KN-NaMi/spin-coater/mechanics/motor_assembly/Motor_assembly.FCStd

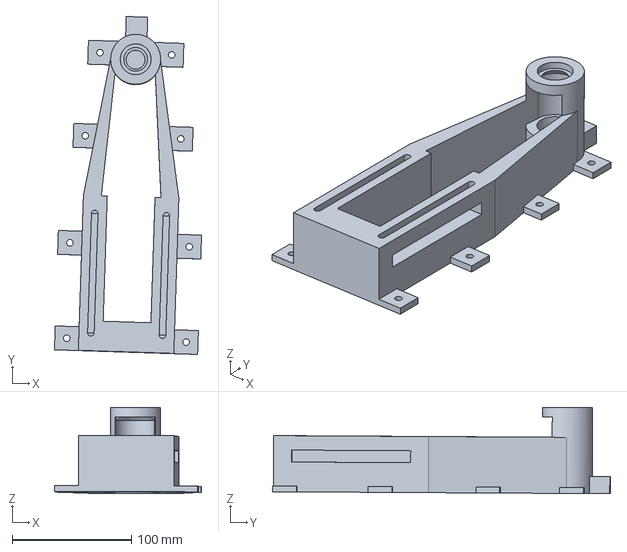
[picture p1: CAD file, 2026-07-07]
mechanics/motor_assembly/Motor_assembly.FCStd
123.2 x 283.1 x 72.3 mm
