KN-NaMi/spin-coater/mechanics/print_files/motor_assembly_tpu.step

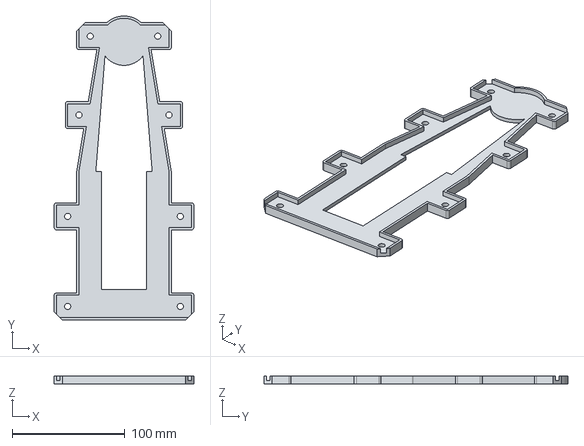
[picture p2: CAD file, 2026-07-07]
mechanics/print_files/motor_assembly_tpu.step
124.0 x 269.9 x 7.00 mm
