KN-NaMi/spin-coater/mechanics/print_files/splatter_guard_main_body.step

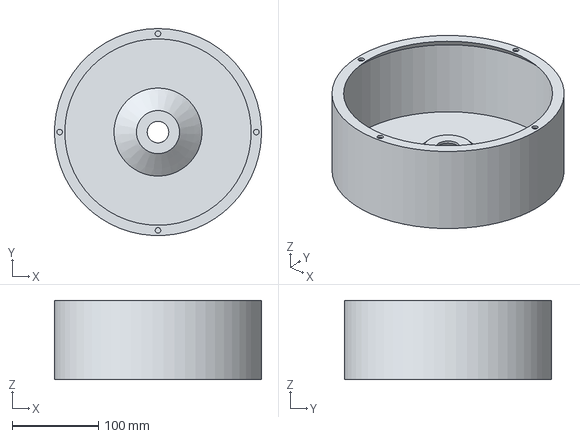
[picture p3: CAD file, 2026-07-07]
mechanics/print_files/splatter_guard_main_body.step
239.9 x 239.8 x 92.0 mm
