KN-NaMi/spin-coater/mechanics/enclosure/enclosure.FCStd

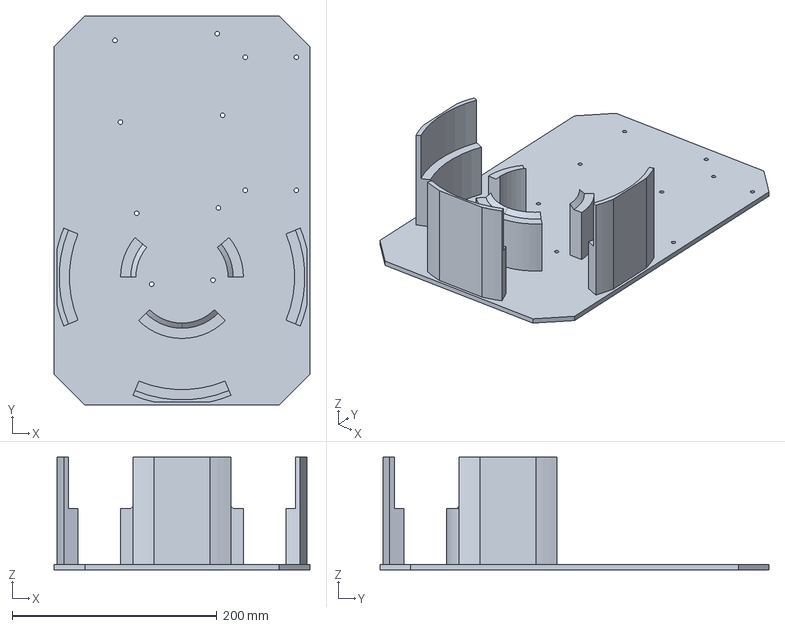
[picture p4: CAD file, 2026-07-07]
mechanics/enclosure/enclosure.FCStd
250.0 x 380.0 x 110.0 mm
