KN-NaMi/spin-coater/mechanics/pulley_parametric/GT2_Pulley_Parametric.FCStd

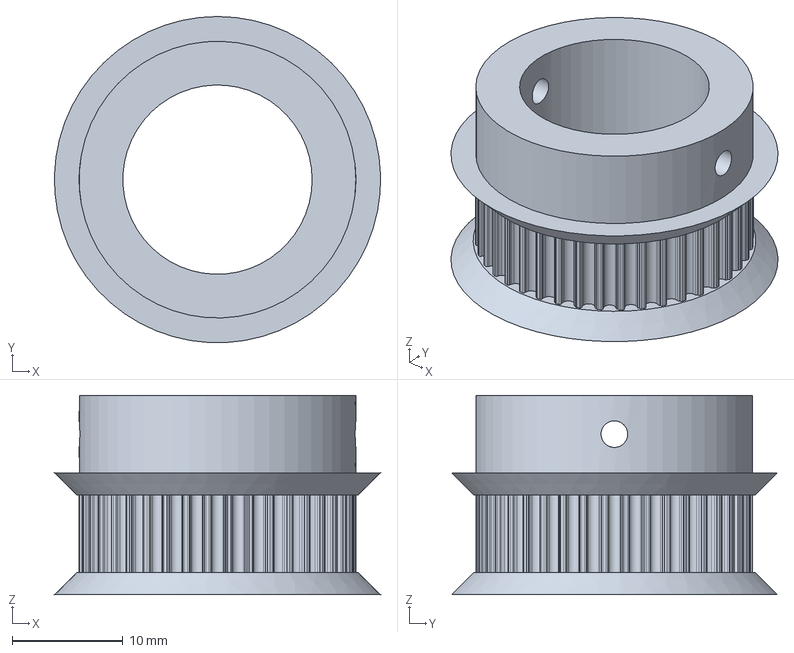
[picture p5: CAD file, 2026-03-24]
mechanics/pulley_parametric/GT2_Pulley_Parametric.FCStd
29.5 x 29.5 x 18.0 mm
