KN-NaMi/spin-coater/mechanics/splatter_guard/Splatter guard.FCStd

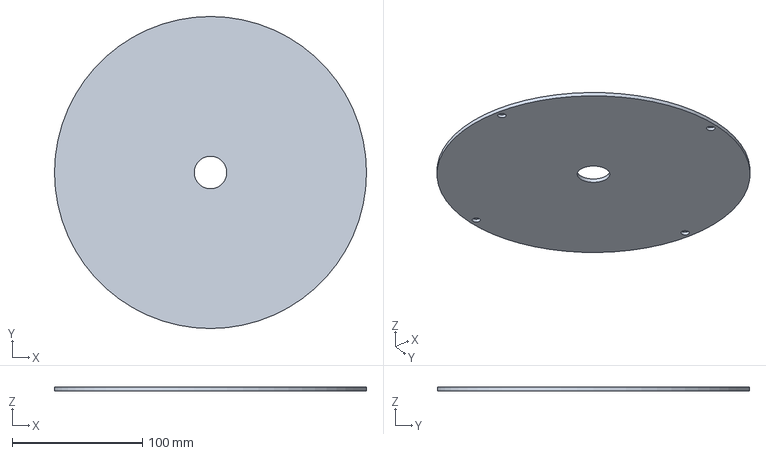
[picture p6: CAD file, 2026-07-07]
mechanics/splatter_guard/Splatter guard.FCStd
240.0 x 240.0 x 3.00 mm
