KN-NaMi/spin-coater/mechanics/Vaccum Pump/Vaccum Pump.FCStd

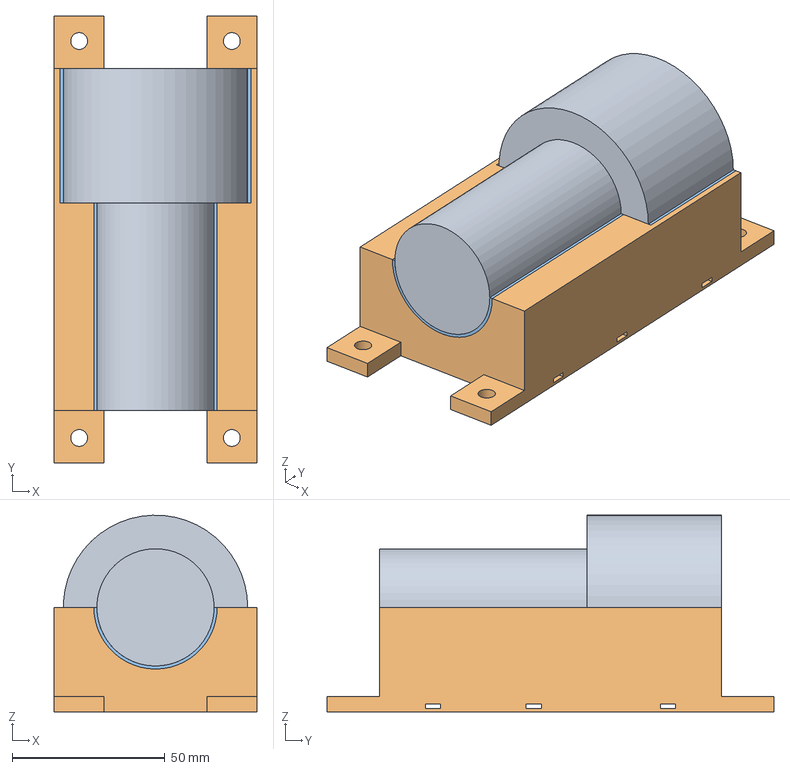
[picture p7: CAD file, 2026-07-07]
mechanics/Vaccum Pump/Vaccum Pump.FCStd
66.4 x 146.4 x 64.4 mm
Motor
Mount
TPU
