KN-NaMi/spin-coater/mechanics/print_files/vaccum_pump_mount.step

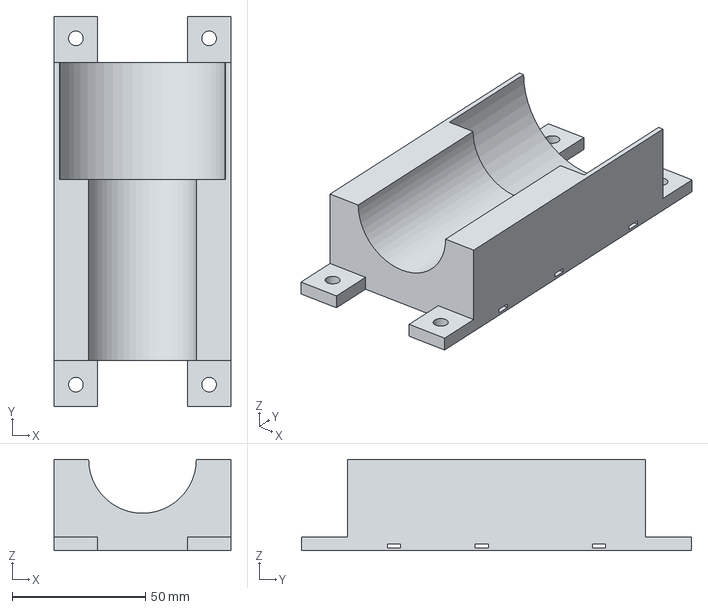
[picture p8: CAD file, 2026-07-07]
mechanics/print_files/vaccum_pump_mount.step
66.4 x 146.4 x 34.2 mm
