KN-NaMi/spin-coater/mechanics/print_files/motor_assembly_screw_plate.step

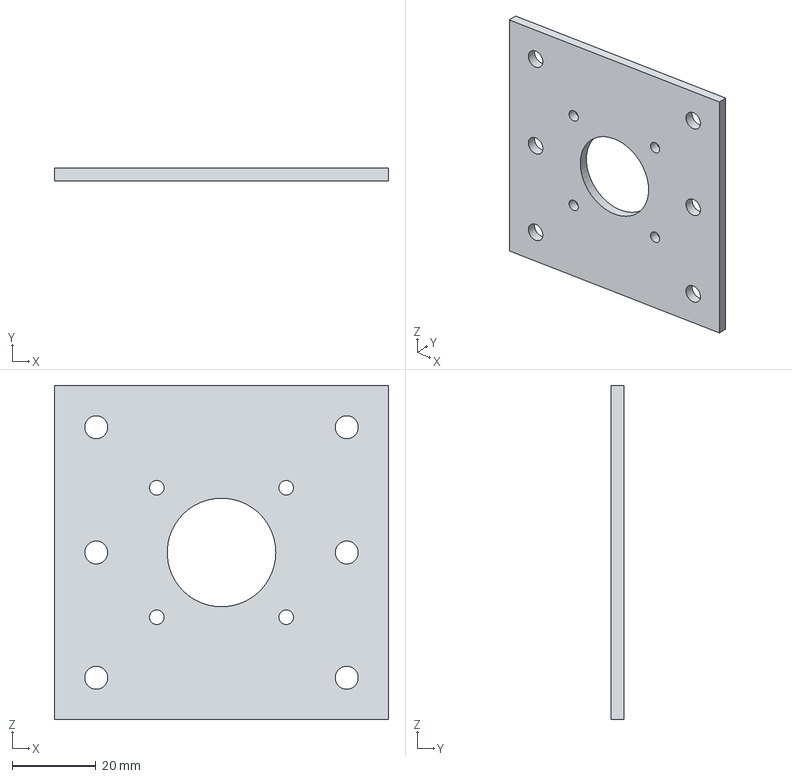
[picture p9: CAD file, 2026-07-07]
mechanics/print_files/motor_assembly_screw_plate.step
80.0 x 3.00 x 80.0 mm
