KN-NaMi/spin-coater/mechanics/print_files/motor_assembly_screw_arms.step

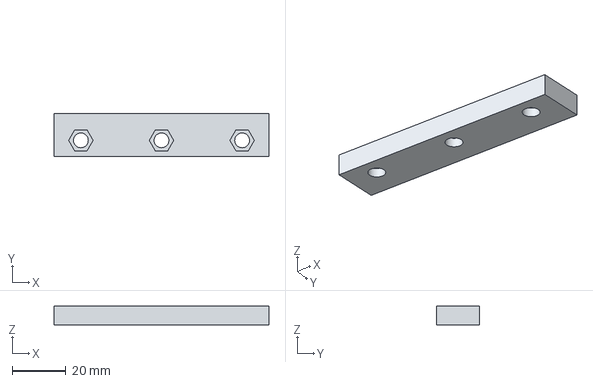
[picture p10: CAD file, 2026-07-07]
mechanics/print_files/motor_assembly_screw_arms.step
80.0 x 16.0 x 7.00 mm
