KN-NaMi/spin-coater/(list of files, cad)

Other CAD files:
mechanics/final_assembly.FCStd
mechanics/print_files/motor_assembly_main_body.step
mechanics/print_files/enclosure_bottom.step
mechanics/print_files/Splatter guard-Top.step
