KN-NaMi/spin-coater/electronics/hall-sensor/hall-sensor.kicad_pcb

## KiCad design electronics/hall-sensor/hall-sensor.kicad_pcb (2026-03-24)

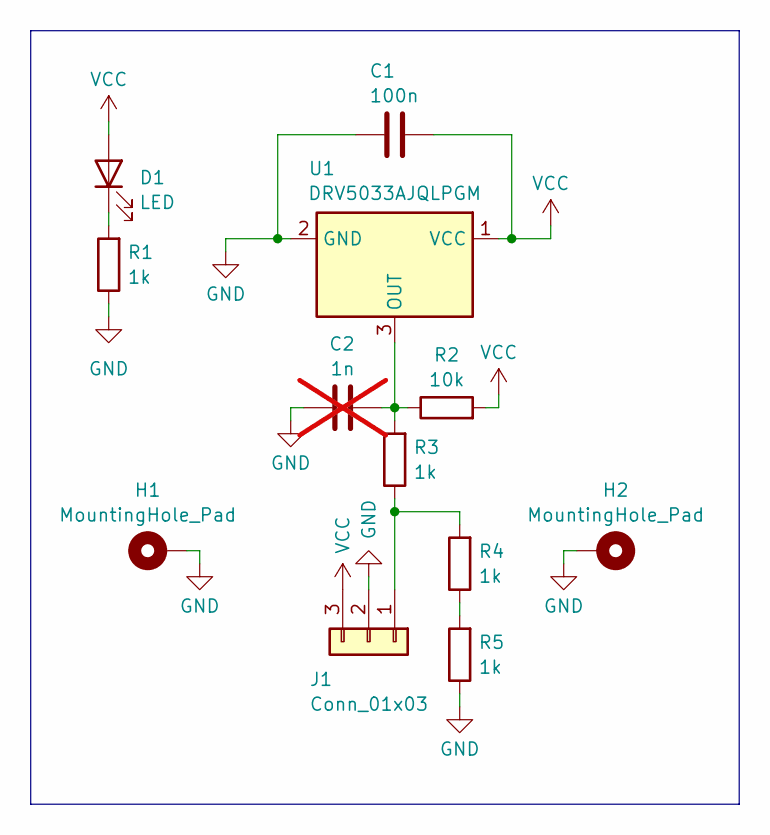
[picture p11: schematic hall-sensor.kicad_sch]

Parts:
C1: 100n; C_0805_2012Metric_Pad1.18x1.45mm_HandSolder
C2: 1n; C_0805_2012Metric_Pad1.18x1.45mm_HandSolder; not fitted
D1: LED; LED_1206_3216Metric
H1, H2: MountingHole_Pad; MountingHole_3.2mm_M3_Pad
J1: Conn_01x03; JST_XH_S3B-XH-A_1x03_P2.50mm_Horizontal
R1, R3, R4, R5: 1k; R_0805_2012Metric
R2: 10k; R_0805_2012Metric_Pad1.20x1.40mm_HandSolder
U1: DRV5033AJQLPGM; TO-92_Horizontal2

Connections:
GND: C1.2, C2.1, H1.1, H2.1, J1.2, R1.1, R5.1, U1.2 (GND)
unnamed: D1.1 (K), R1.2
unnamed: J1.1, R3.1, R4.2
unnamed: R4.1, R5.2
unnamed: C2.2, R2.1, R3.2, U1.3 (OUT)
VCC: C1.1, D1.2 (A), J1.3, R2.2, U1.1 (VCC)

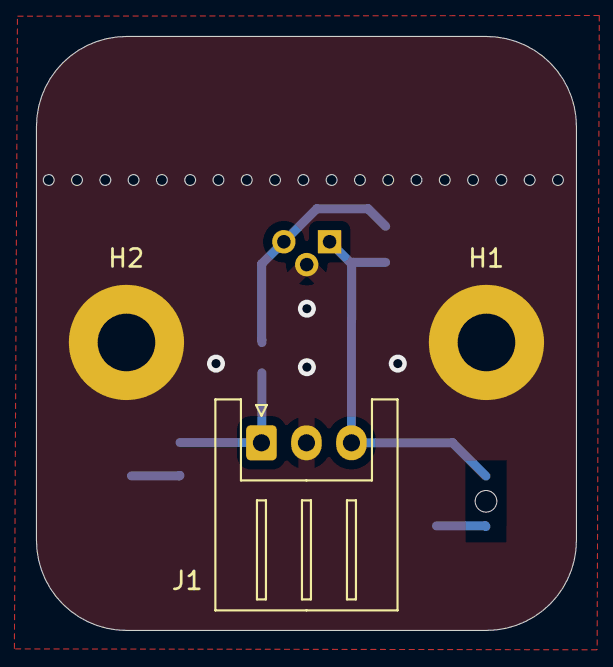
[picture p12: board hall-sensor.kicad_pcb from above]

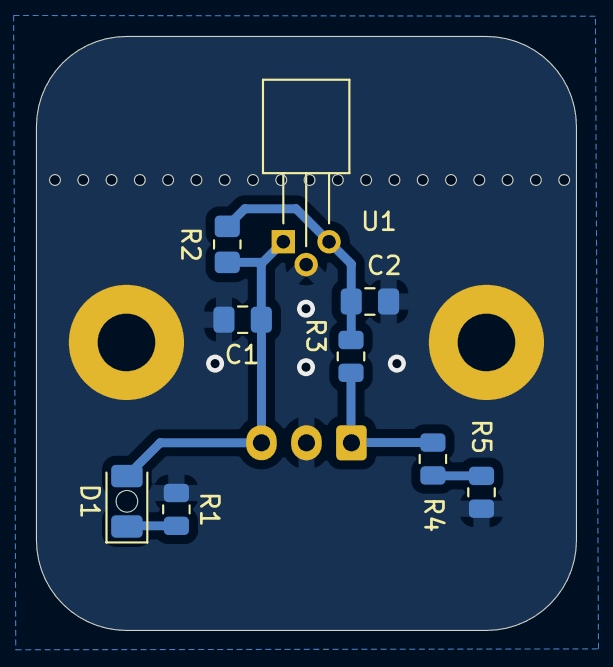
[picture p13: board hall-sensor.kicad_pcb from below]

Board: 2 copper layers, 30.0 x 33.0 mm, 12 parts (9 on the bottom side), 6 nets.
