KN-NaMi/spin-coater/electronics/main-board/main-board.kicad_pcb

## KiCad design electronics/main-board/main-board.kicad_pcb (2026-03-24)

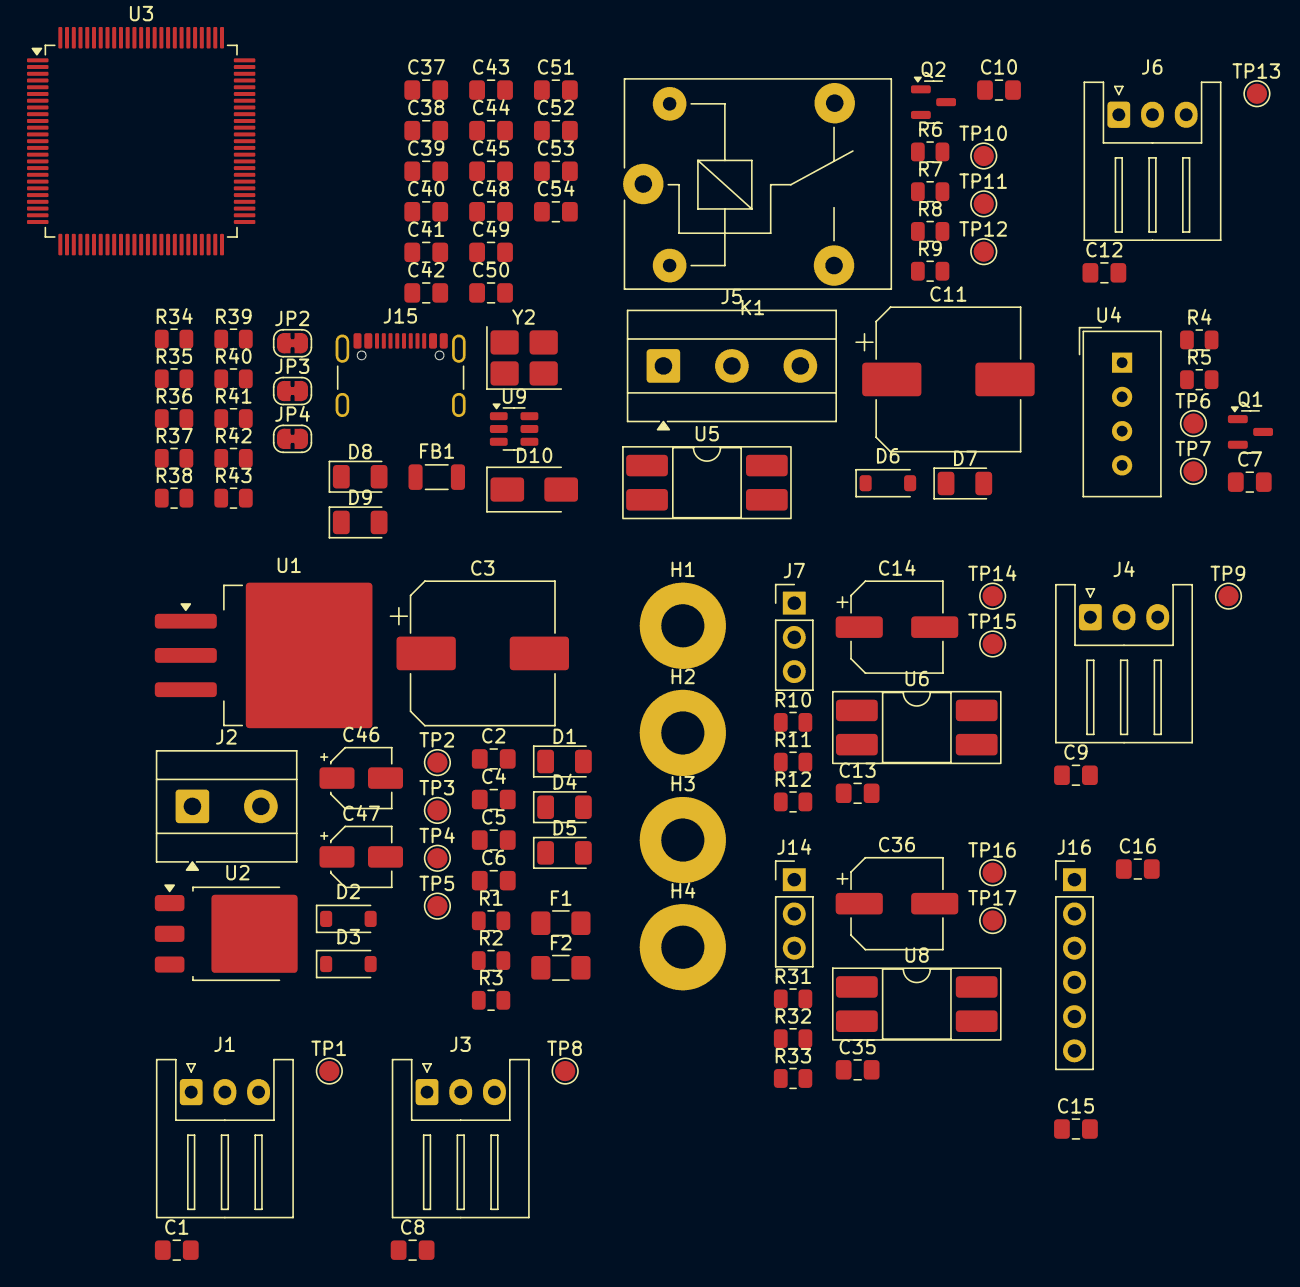
[picture p14: board main-board.kicad_pcb from above]

Board: 2 copper layers, 120 parts (0 on the bottom side), 48 nets, no tracks yet.

Parts:
C1, C2, C4, C5, C6, C7, C8, C9, C10, C12, C13, C15, C16, C35, C37, C38, C39, C40, C41, C42, C43, C44, C45, C52: 100n; C_0805_2012Metric_Pad1.18x1.45mm_HandSolder
C3, C11: 220u; CP_Elec_10x10.5
C14, C36: 100u; CP_Elec_6.3x5.4
C46, C47: 10u; CP_Elec_4x5.4
C48, C49: 2n2; C_0805_2012Metric_Pad1.18x1.45mm_HandSolder
C50: 10p; C_0805_2012Metric_Pad1.18x1.45mm_HandSolder
C51: 20p; C_0805_2012Metric_Pad1.18x1.45mm_HandSolder
C53, C54: 470n; C_0805_2012Metric_Pad1.18x1.45mm_HandSolder
D1, D4, D5, D7, D8, D9: LED; LED_1206_3216Metric
D2, D3, D6: 1N4148W; D_SOD-123
D10: SS34; D_SMA
F1: 3A; Fuse_1206_3216Metric_Pad1.42x1.75mm_HandSolder
F2: 500mA; Fuse_1206_3216Metric_Pad1.42x1.75mm_HandSolder
FB1: FerriteBead; L_1206_3216Metric
H1, H2, H3, H4: MountingHole_Pad; MountingHole_3.2mm_M3_Pad
J1, J3, J4, J6: HALL-SENSOR; JST_XH_S3B-XH-A_1x03_P2.50mm_Horizontal
J2: 24V-IN; TerminalBlock_MetzConnect_Type101_RT01602HBWC_1x02_P5.08mm_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
J5: VACUME-PUMP; TerminalBlock_MetzConnect_Type101_RT01603HBWC_1x03_P5.08mm_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
J7, J14: SERVO_MOTOR-OUT; PinHeader_1x03_P2.54mm_Vertical
J15: SHOU HAN TYPE-C 16PIN 2MD; USB_C_Receptacle_GCT_USB4105-xx-A_16P_TopMnt_Horizontal
J16: UART; PinHeader_1x06_P2.54mm_Vertical
JP2, JP3, JP4: SolderJumper_2_Bridged; SolderJumper-2_P1.3mm_Bridged_RoundedPad1.0x1.5mm
K1: SRD-05VDC-SL-C; Relay_SPDT_SANYOU_SRD_Series_Form_C
Q1: BSS138; SOT-23
Q2: MMBT2222A; SOT-23
R1, R4, R5, R8, R9, R12, R33, R34, R35: 10k; R_0805_2012Metric
R2, R3, R7, R11, R32, R36, R37: 1k; R_0805_2012Metric
R6, R10, R31: 330; R_0805_2012Metric
R38, R39, R43: 0; R_0805_2012Metric
R40, R41: 5k1; R_0805_2012Metric
R42: 1M; R_0805_2012Metric
TP1, TP2, TP3, TP4, TP5, TP6, TP7, TP8, TP9, TP10, TP11, TP12, TP13, TP14, TP15, TP16, TP17: TestPoint; TestPoint_Pad_D1.5mm
U1: L7805; TO-263-3_TabPin2
U2: AMS1117CD-3.3; TO-252-3_TabPin2
U3: STM32F407V_E-G_Tx; LQFP-100_14x14mm_P0.5mm
U4: DHT11; Aosong_DHT11_5.5x12.0_P2.54mm
U5, U6, U8: EL817S1; DIP-4_W8.89mm_SMDSocket_LongPads
U9: SRV05-4; SOT-23-6
Y2: X322516MLB4SI; Crystal_SMD_3225-4Pin_3.2x2.5mm_HandSoldering

Connections:
+3V3: C1.2, C6.2, C8.2, C9.2, C12.2, C15.2, C16.2, C38.2, C39.2, C40.2, C41.2, C42.2, C43.2, C47.1, D3.2 (A), D5.2 (A), J1.1, J3.1, J4.1, J6.1, J16.2, J16.5, JP2.1 (A), JP3.1 (A), JP4.1 (A), Q1.1 (G), R4.2, R34.2, TP5.1, U2.2 (VO), U3.11 (VDD), U3.19 (VDD), U3.28 (VDD), U3.50 (VDD), U3.75 (VDD), U3.100 (VDD), U9.5 (VP)
+5V: C5.2, C7.2, C13.2, C14.1, C35.2, C36.1, C46.1, C53.2, D2.2 (A), D3.1 (K), D4.2 (A), D6.1 (K), J7.2, J14.2, K1.2, R5.2, R43.1, TP4.1, U1.3 (OUT), U2.3 (VI), U4.1 (VDD), U5.4, U6.4, U8.4
+24V: C10.2, C11.1, D1.2 (A), F1.2, K1.1, TP2.1
/DHT11/DHT11: Q1.2 (S), R4.1, TP6.1
/STM/BOOT: R35.2, U3.94 (BOOT0)
/STM/NRST: C37.2, R34.1, U3.14 (NRST)
/STM/USB_OTG_FS_DN: J15.A7 (D-), J15.B7 (D-), U3.70 (PA11), U9.3 (IO2), U9.6 (IO4)
/STM/USB_OTG_FS_DP: J15.A6 (D+), J15.B6 (D+), U3.71 (PA12), U9.1 (IO1), U9.4 (IO3)
/STM/VA: C45.2, FB1.2, U3.22 (VDDA)
/hall-sensor1/HALL: J1.3, TP1.1
/hall-sensor2/HALL: J3.3, TP8.1
/hall-sensor3/HALL: J6.3, TP13.1
/hall-sensor/HALL: J4.3, TP9.1
GND: C1.1, C2.1, C3.2, C4.1, C5.1, C6.1, C7.1, C8.1, C9.1, C10.1, C11.2, C12.1, C13.1, C14.2, C15.1, C16.1, C35.1, C36.2, C37.1, C38.1, C39.1, C40.1, C41.1, C42.1, C43.1, C44.1, C45.1, C46.2, C47.2, C48.1, C49.1, C50.1, C51.1, C52.1, C53.1, C54.1, H1.1, H2.1, H3.1, H4.1, J1.2, J2.1, J3.2, J4.2, J5.3, J6.2, J7.3, J14.3, J15.A1 (GND), J15.A12 (GND), J15.B1 (GND), J15.B12 (GND), J15.S1 (SHIELD), J16.1, J16.6, Q2.2 (E), R1.1, R2.1, R3.1, R8.2, R9.1, R12.2, R33.2, R35.1, R36.1, R37.1, R40.1, R41.1, U1.2 (GND), U2.1 (GND), U3.10 (VSS), U3.20 (VSSA), U3.27 (VSS), U3.74 (VSS), U3.99 (VSS), U4.4 (GND), U5.2, U6.2, U8.2, U9.2 (VN), Y2.2, Y2.4
unnamed: C50.2, R38.1, Y2.1
unnamed: C51.2, R39.1, Y2.3
unnamed: D1.1 (K), R1.2
unnamed: C4.2, D2.1 (K), F2.2, U1.1 (IN)
unnamed: D4.1 (K), R2.2
unnamed: D5.1 (K), R3.2
unnamed: D6.2 (A), K1.5, Q2.3 (C), TP10.1
unnamed: D7.2 (A), J5.1, K1.3
unnamed: D7.1 (K), R9.2
unnamed: D8.1 (K), R36.2
unnamed: D9.1 (K), R37.2
unnamed: D10.2 (A), J15.A4 (VBUS), J15.A9 (VBUS), J15.B4 (VBUS), J15.B9 (VBUS)
unnamed: C54.2, D10.1 (K), R43.2
unnamed: C2.2, C3.1, F1.1, F2.1, J2.2, TP3.1
unnamed: J5.2, K1.4
unnamed: J7.1, R11.2, R12.1, TP15.1
unnamed: J14.1, R32.2, R33.1, TP17.1
unnamed: J15.A5 (CC1), R41.2
unnamed: J15.B5 (CC2), R40.2
unnamed: Q1.3 (D), R5.1, TP7.1, U4.2 (DATA)
unnamed: Q2.1 (B), R7.2, R8.1, TP12.1
unnamed: R6.2, TP11.1, U5.1
unnamed: R7.1, U5.3
unnamed: R10.2, TP14.1, U6.1
unnamed: R11.1, U6.3
unnamed: R31.2, TP16.1, U8.1
unnamed: R32.1, U8.3
unnamed: R38.2, R42.1, U3.12 (PH0)
unnamed: R39.2, R42.2, U3.13 (PH1)
unnamed: C48.2, U3.49 (VCAP_1)
unnamed: C49.2, U3.73 (VCAP_2)
VBAT: C44.2, JP2.2 (B), U3.6 (VBAT)
VDDA: FB1.1, JP3.2 (B)
VREF: C52.2, JP4.2 (B), U3.21 (VREF+)
