KN-NaMi/spin-coater/Speed controler tests.xlsx

 | Scope |  | STM32 |  |  |  | Scope |  | STM32 |  |  |  | Scope |  | STM32
 | freq | RPM | freq | RPM |  |  | freq | RPM | freq | RPM |  |  | freq | RPM | freq | RPM
seria 1 | 5.714 | 342.84 | 5 | 300 |  | seria 2 | 7.4 | 444 | 7 | 420 |  | seria 3 | 14.3 | 858 | 15 | 900
 | 5.405 | 324.3 | 6 | 360 |  |  | 7.7 | 462 | 8 | 480 |  |  | 15.4 | 924 | 16 | 960
 | 5.556 | 333.36 |  |  |  |  | 7.7 | 462 |  |  |  |  | 15.3 | 918
 |  |  |  |  |  |  | 6.9 | 414 |  |  |  |  | 16.6 | 996
 |  |  |  |  |  |  | 7.4 | 444 |  |  |  |  | 15.4 | 924
 |  |  |  |  |  |  | 7.1 | 426 |  |  |  |  | 16.7 | 1002
 |  |  |  |  |  |  |  |  |  |  |  |  | 15.4 | 924
avg | 5.558333333 | 333.5 | 5.5 | 330 |  | avg | 7.366666667 | 442 | 7.5 | 450 |  | avg | 15.58571429 | 935.1428571 | 15.5 | 930
róznica | 0.05833333333 | 3.5 | czyli | 1.055011304 | % | róznica | 0.1333333333 | 8 | czyli | 1.93236715 | % | róznica | 0.08571428571 | 5.142857143 | czyli | 0.5163511188 | %
