KN-NaMi/spin-coater/(commit log)

2025-10-29 init repo
    [case-middle-part.FCStd]
2025-11-06 added manufacturer's .step of used motor
2025-11-06 Initial assembly of motor bracket
    [Motor_mount_assembly-mounting_plate.step, Motor_mount_assembly.FCStd]
2025-11-06 moved parts & parameters to separate files
    [Motor_mount_assembly.FCStd, motor_bracket.FCStd, motor_mount_parameters.FCStd, motor_plate.FCStd]
2025-11-06 added 608 bearing model & sources for .step's
    [Bearing_608.STEP]
2025-11-06 Moved motor mount assembly to separate folder
    [Motor_mount_assembly-mounting_plate.step, Motor_mount_assembly.FCStd, motor_bracket.FCStd, motor_mount_parameters.FCStd, motor_plate.FCStd]
2025-11-08 Added main shaft assembly and GT2 Pulley parameteric
    [GT2_Pulley_Parametric-Body.step, GT2_Pulley_Parametric.FCStd, Hollow_shaft-Part.step, Hollow_shaft.FCStd, Motor_mount_assembly.FCStd, Shaft_assembly.FCStd, TEST_____motor_bracket-motor_bracketSketch004.step, TEST_main_body.stp]
2025-11-13 Added schematic of prototype
    [bluepill_prototype.kicad_pcb, bluepill_prototype.kicad_sch]
2025-11-13 Added turntable and magnet mount
    [Hall sensor & magnet-hall_sensor_ca_glue.step, Hall sensor & magnet-magnet_mountBody.step, Hall sensor & magnet.FCStd, Hollow_shaft-Part R2 - added m12 thread.step, Hollow_shaft.FCStd, Spinning-Part.step, Spinning.FCStd, shaft_assembly_parameters.FCStd]
2025-11-15 Added complete assembly
    [Hollow_shaft.FCStd, Motor_mount_assembly.FCStd, Shaft_assembly.FCStd, Spinning.FCStd, complete_assembly.FCStd, main_body.FCStd, motor_bracket.FCStd, mounting_plate.FCStd]
2025-11-18 Fixed parametric pulley
    [GT2_Pulley_Parametric.FCStd]
2025-11-18 Added pulley tensioner
    [pulley_tensioner.FCStd]
2025-11-18 Added splatter guide to complete assembly
    [Motor_mount_assembly.FCStd, Shaft_assembly.FCStd, Spinning.FCStd, case-middle-part.FCStd, complete_assembly.FCStd]
2025-11-22 updated assembly to fit belt tensioner
    [GT2_Pulley_Parametric-Body.step, GT2_Pulley_Parametric.FCStd, Hall sensor & magnet-hall_sensor_ca_glue.step, Hall sensor & magnet-magnet_mountBody.step, Hollow_shaft-Part R2 - added m12 thread.step, Hollow_shaft-Part.step, Hollow_shaft.FCStd, Motor_mount_assembly.FCStd]
2025-11-22 fixed parametric pulley again
    [GT2_Pulley_Parametric.FCStd]
2025-11-22 fixed fixed parametric pulley
    [GT2_Pulley_Parametric.FCStd]
2025-11-23 chore: moved .step to seperate folders
    [GT2_Pulley Body 48 teeth 8.15 hole diameter.step, GT2_Pulley_Parametric-Body.step, GT2_Pulley_Parametric.FCStd, Hall sensor & magnet-hall_sensor_ca_glue.step, Hall sensor & magnet-magnet_mount.step, Hall sensor & magnet-magnet_mountBody.step, Hall sensor & magnet.FCStd, Hollow_shaft-Part R2 - added m12 thread.step]
2025-11-23 feat: added vaccum version to spintable
    [Spinning-Partseal.step, Spinning-Partspinning.step, Spinning.FCStd]
2025-11-23 feat: added vacum PTFE tube adapter for testing
    [PTFE to shaft adapter for testing-PartBody.step, PTFE to shaft adapter for testing.FCStd]
2025-11-23 feat: changed turntable to use TPU seal
    [Spinning-Partseal 2.step, Spinning-Partspinning.step, Spinning.FCStd]
2025-11-25 changed to ceramic bearings
    [Hollow_shaft-Part.step, Hollow_shaft.FCStd, Shaft_assembly.FCStd, complete_assembly.FCStd, main_body-Assemblymain_body.step, main_body.FCStd, shaft_assembly_parameters.FCStd]
2025-12-08 feat: changed main body to accept new bearings
    [Hollow_shaft-Assemblyshaft 17x11 .stl, Hollow_shaft-Assemblyshaft 17x13 .stl, Hollow_shaft.FCStd, Shaft_assembly.FCStd, case-middle-part-case_splatter_guard001case_splatter_guard.step, case-middle-part.FCStd, complete_assembly.FCStd, main_body.FCStd]
2025-12-10 feat: tested v0.1 speed controler
    [Speed controler tests.xlsx]
2026-02-27 feat: updated electronic schematic
    [bluepill_prototype.kicad_sch]
2026-02-27 feat: modeled vaccum axile
    [Bearing Test-Body 25.85mm.step, Bearing Test-Body 25.9mm.step, Bearing Test-Body 26mm.step, Bearing Test-Body Closed.step, Bearing Test.FCStd, Big pulley.step, Dimensions.FCStd, GT2_Pulley_Parametric.FCStd]
2026-03-07 removed test files
    [Bearing Test-Body 25.85mm.step, Bearing Test-Body 25.9mm.step, Bearing Test-Body 26mm.step, Bearing Test-Body Closed.step, Hollow_shaft-PartBody.step, Hollow_shaft.FCStd, internal 17.3 R2.step, internal 17.3.step]
2026-03-07 fixed schematic
    [bluepill_prototype.kicad_sch]
2026-03-08 add hall sensor and main board
    [DHT11.kicad_sch, NaMi-Menu.kicad_sch, ST-Link.kicad_sch, STM.kicad_sch, USB-C.kicad_sch, ethernet.kicad_sch, hall-sensor.kicad_pcb, hall-sensor.kicad_sch]
2026-03-10 voltage divider added for output pin of hall sensor
    [hall-sensor.kicad_pcb, hall-sensor.kicad_sch]
2026-03-14 feat: PID controller
2026-03-24 small tweak of mountig hole on hall-sensor board
    [hall-sensor.kicad_pcb]
2026-03-24 feat: updated prototype schematic
    [bluepill_prototype.kicad_sch]
2026-05-11 added primitive enclosure
    [Bearing Pushing Jig.stp, Bearing Test.FCStd, Bearing_608.STEP, Big pulley.step, Dimensions.FCStd, GT2_Pulley Body 24 teeth 8.15 hole diameter.step, GT2_Pulley Body 48 teeth 8.15 hole diameter.step, GT2_Pulley_Parametric.FCStd]
2026-05-21 safety commit
    [Motor_assembly.FCStd, Splatter guard.FCStd, Vaccum Pump-Vaccum PumpMount.step, Vaccum Pump.FCStd, enclosure.FCStd, final_assembly.FCStd]
2026-05-21 generated print files
    [Bearing Pushing Jig.stp, Bearing Test.FCStd, Bearing_608.STEP, Big pulley.step, Dimensions.FCStd, GT2_Pulley Body 24 teeth 8.15 hole diameter.step, GT2_Pulley Body 48 teeth 8.15 hole diameter.step, GT2_Pulley_Parametric.FCStd]
2026-06-14 temporary commit
    [Motor_assembly.FCStd, Splatter guard-Top.step, Splatter guard.FCStd, enclosure.FCStd, final_assembly.FCStd, motor_assembly_main_body.step]
2026-06-14 working PWM
2026-06-21 debug code for motor
2026-07-01 Motor spinning (no FOC yet)
2026-07-08 fix:timer display
